RobMeades/spider_launcher/README.md

# Introduction
This repo contains the 3D printed parts and software for the spider launcher, a Halloween feature intended to scare \[playfully\].  For assembly instructions see here:

https://www.meades.org/misc/halloween_2026/halloween_2026.html#Something_Scary_In_The_South_West_Corner
