RobMeades/spider_launcher/sounds/README.md

These are the sounds played by the audio board in the spider launcher.

`00004.mp3` is the main sound, the one played while the spider is jumping, which also has an Audacity (v2) project file since it is a mixture of these two:

https://freesound.org/people/Mastersoundboy2005/sounds/737273/
https://sounds.sfxengine.com/big-spider-attack-jp5xxakt.wav

`00005.mp3` is mostly just this sound, amplified in two steps:

https://freesound.org/people/InsanityZeta/sounds/702986/
