RobMeades/spider_launcher/blender/spider_launcher_box.stl

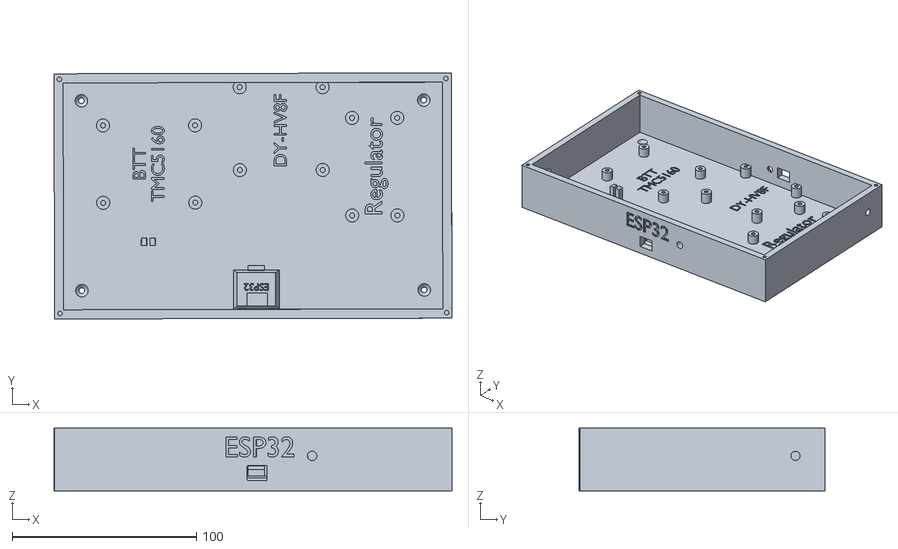
[picture p1: CAD file, 2026-10-25]
blender/spider_launcher_box.stl
216.2 x 133.6 x 34.0
