RobMeades/spider_launcher/blender/spider_launcher_winch_wheel.stl

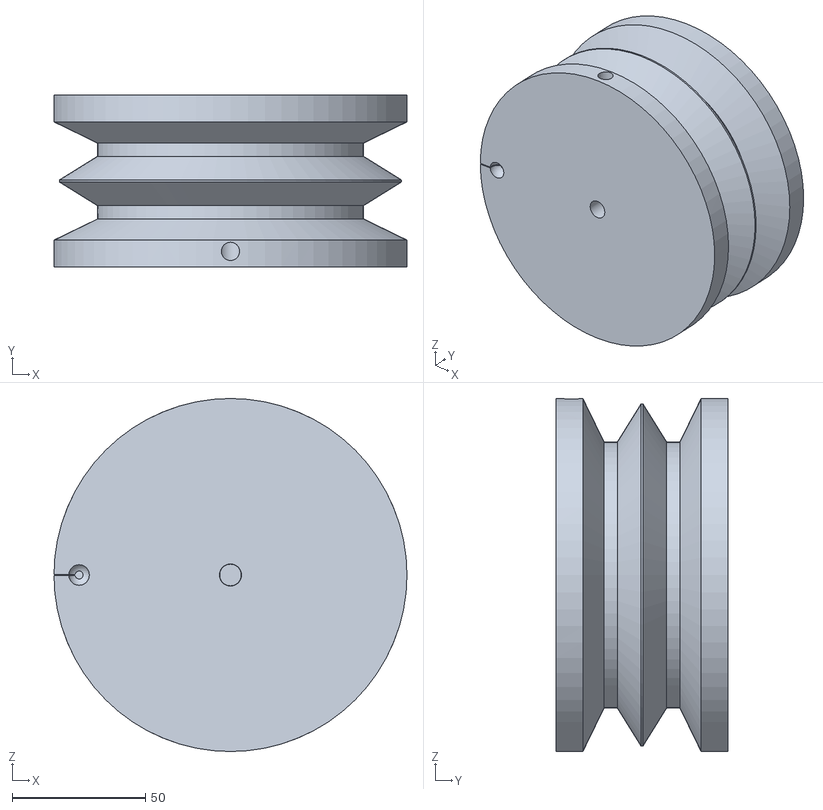
[picture p2: CAD file, 2026-10-25]
blender/spider_launcher_winch_wheel.stl
132.6 x 64.4 x 132.6
