RobMeades/spider_launcher/blender/spider_launcher_winch_mount_motor_side.stl

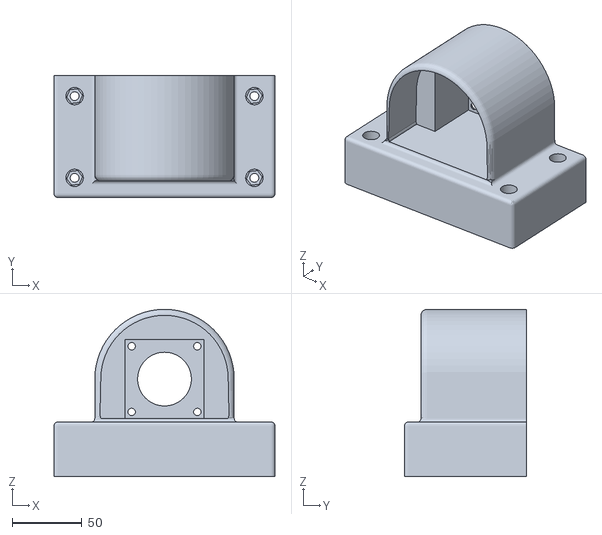
[picture p3: CAD file, 2026-10-23]
blender/spider_launcher_winch_mount_motor_side.stl
158.4 x 87.5 x 120.0
