RobMeades/spider_launcher/blender/spider_launcher_winch_mount_spacer_x2.stl

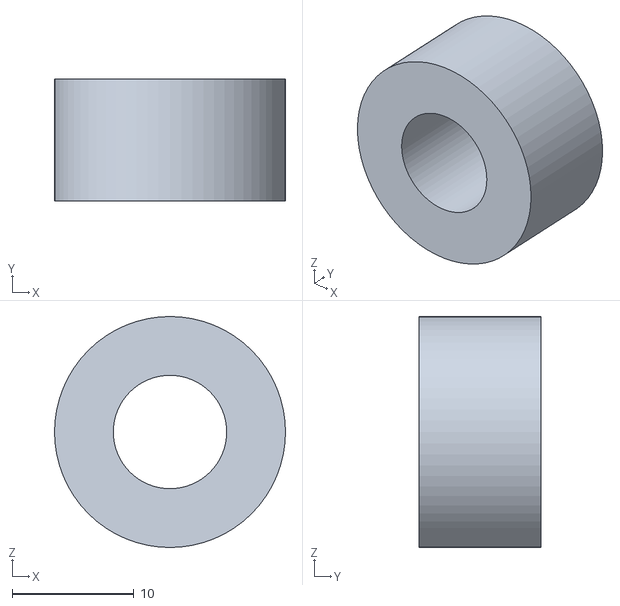
[picture p4: CAD file, 2026-10-23]
blender/spider_launcher_winch_mount_spacer_x2.stl
19.0 x 10.0 x 19.0
