RobMeades/spider_launcher/blender/spider_launcher_box_speaker_housing.stl

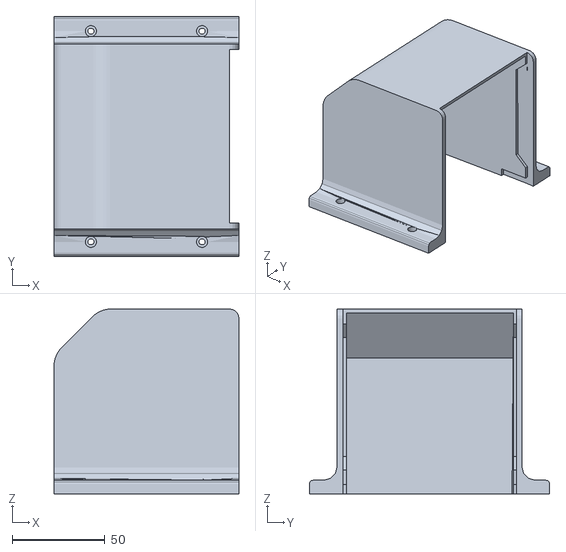
[picture p5: CAD file, 2026-10-16]
blender/spider_launcher_box_speaker_housing.stl
100.0 x 129.9 x 100.0
