RobMeades/spider_launcher/blender/spider_launcher_box_lid.stl

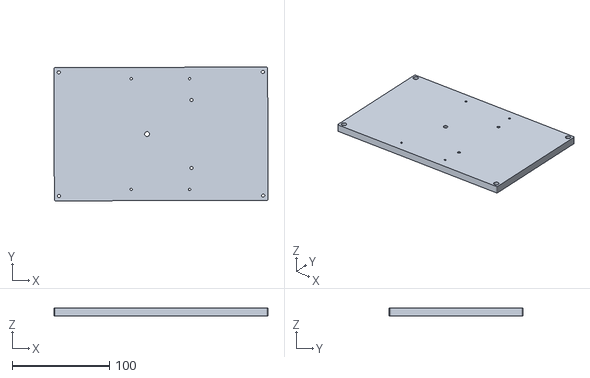
[picture p6: CAD file, 2026-10-16]
blender/spider_launcher_box_lid.stl
220.2 x 137.7 x 8.00
