RobMeades/spider_launcher/blender/spider_launcher_box_speaker_front.stl

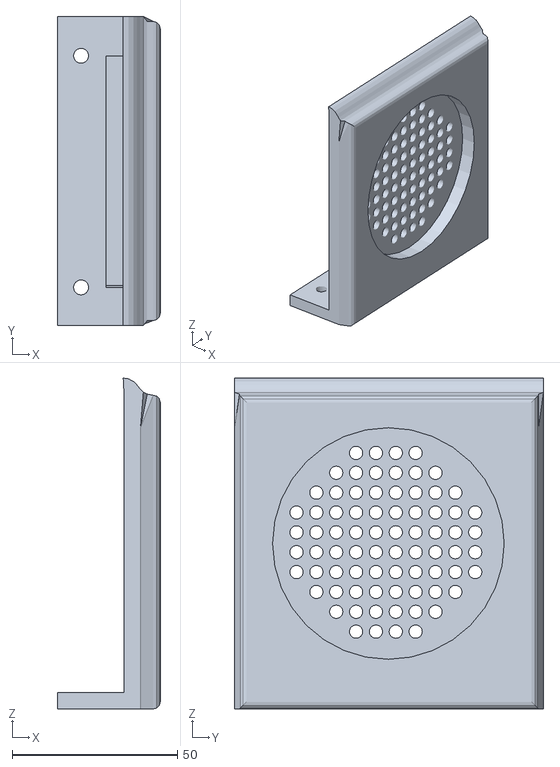
[picture p7: CAD file, 2026-10-16]
blender/spider_launcher_box_speaker_front.stl
31.0 x 93.4 x 100.0
