RobMeades/spider_launcher/blender/spider_launcher_spider_eye_big_lens_x2.stl

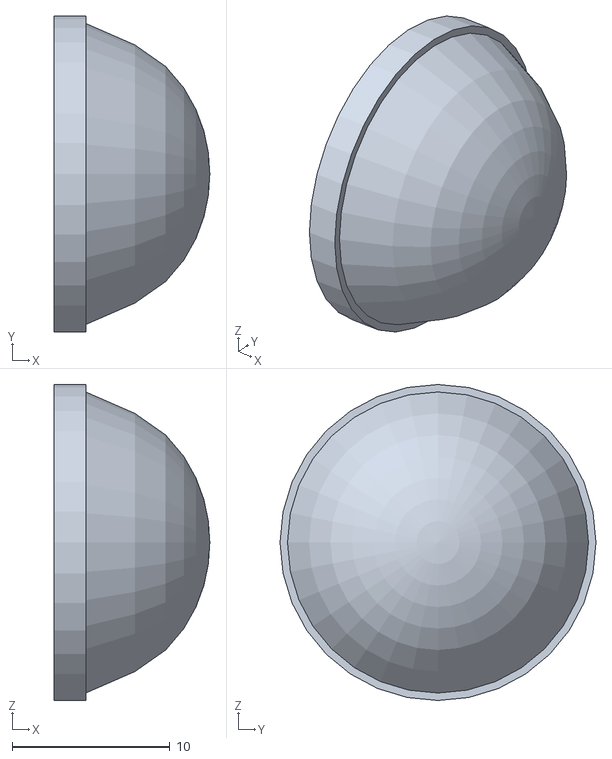
[picture p8: CAD file, 2026-10-11]
blender/spider_launcher_spider_eye_big_lens_x2.stl
9.85 x 20.0 x 20.0
