RobMeades/spider_launcher/blender/spider_launcher_spider_eye_mount.stl

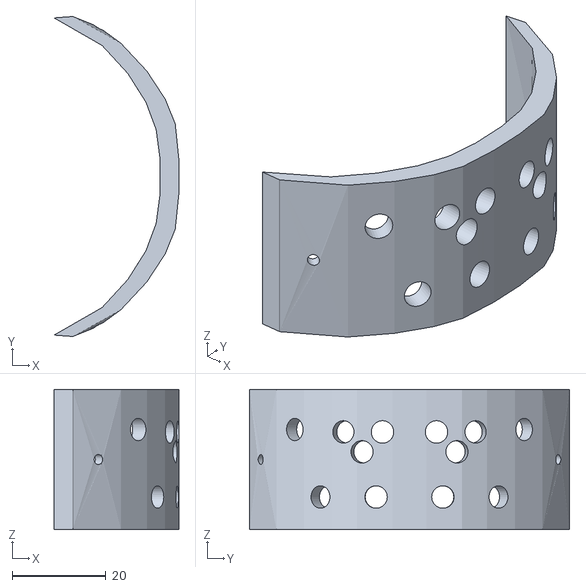
[picture p9: CAD file, 2026-10-09]
blender/spider_launcher_spider_eye_mount.stl
26.7 x 68.4 x 30.0
