RobMeades/spider_launcher/blender/spider_launcher_spider_box.stl

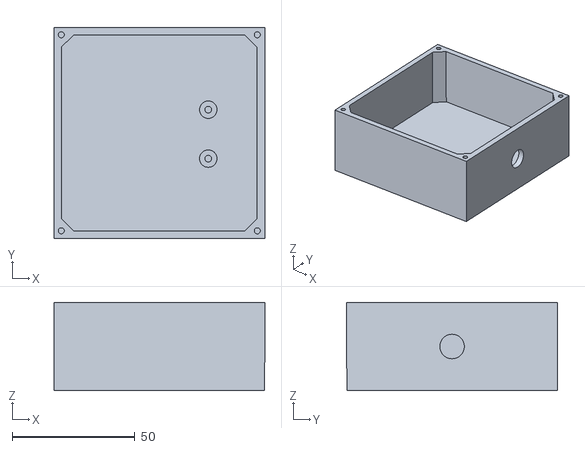
[picture p10: CAD file, 2026-10-09]
blender/spider_launcher_spider_box.stl
86.1 x 86.1 x 36.0
