RobMeades/spider_launcher/blender/spider_launcher_spider_box_lid.stl

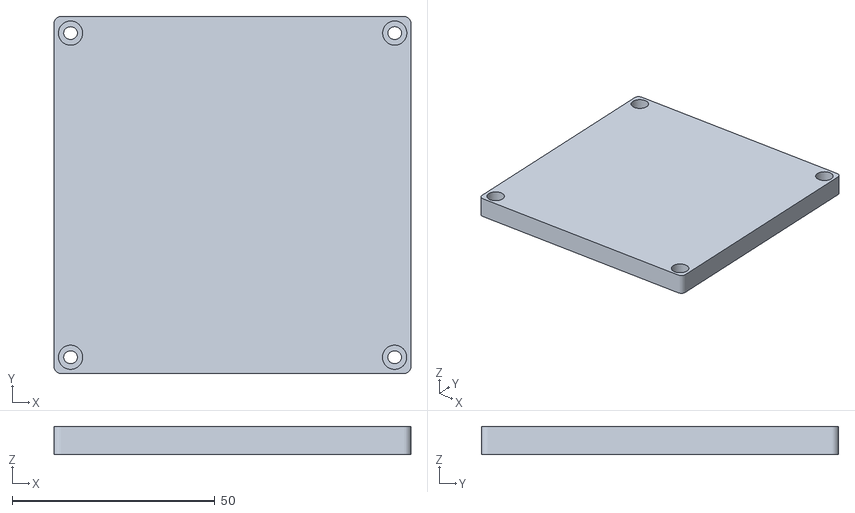
[picture p11: CAD file, 2026-10-09]
blender/spider_launcher_spider_box_lid.stl
88.1 x 88.1 x 7.00
