RobMeades/spider_launcher/blender/spider_launcher_platform_cable_joint_x2.stl

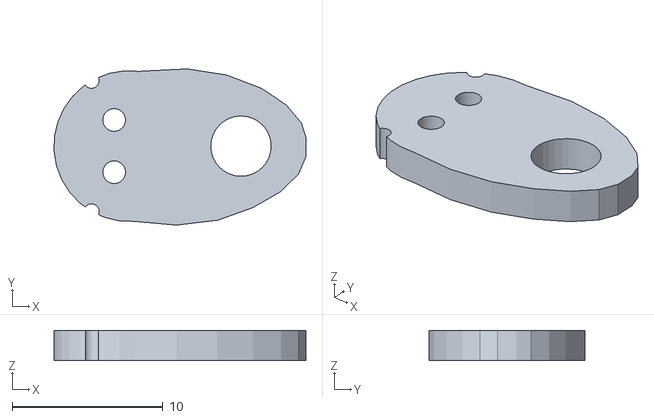
[picture p12: CAD file, 2026-10-05]
blender/spider_launcher_platform_cable_joint_x2.stl
16.7 x 10.4 x 2.00
