RobMeades/spider_launcher/blender/spider_launcher_winch_mount_non-motor_side_lower.stl

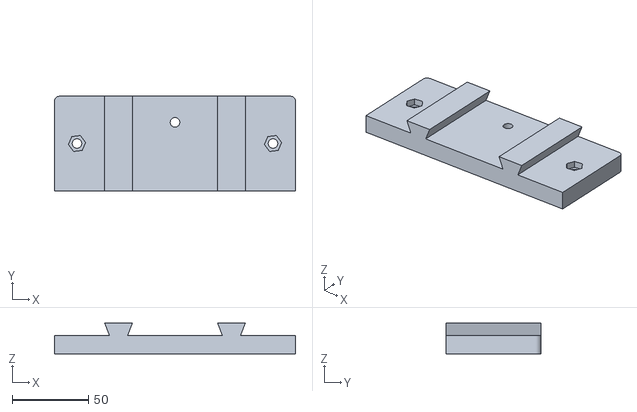
[picture p13: CAD file, 2026-10-02]
blender/spider_launcher_winch_mount_non-motor_side_lower.stl
158.4 x 62.2 x 20.1
