RobMeades/spider_launcher/blender/spider_launcher_box_lid_usb_c_hole_cap_x2.stl

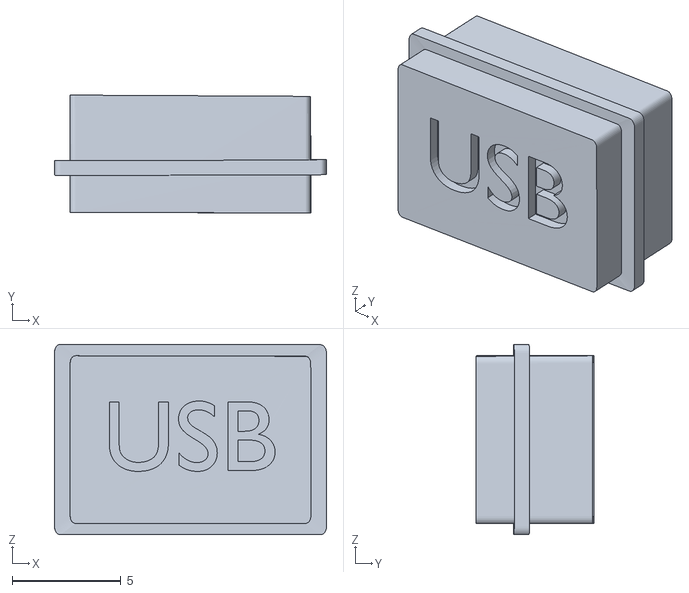
[picture p14: CAD file, 2026-10-02]
blender/spider_launcher_box_lid_usb_c_hole_cap_x2.stl
12.5 x 5.42 x 8.77
