RobMeades/spider_launcher/blender/spider_launcher_winch_motor_bracket.stl

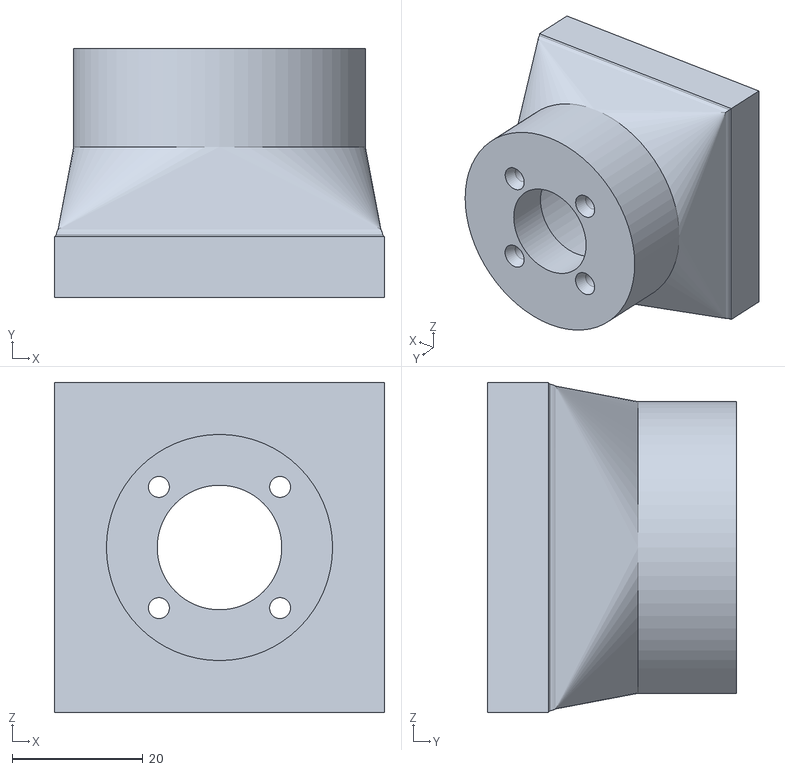
[picture p15: CAD file, 2026-10-02]
blender/spider_launcher_winch_motor_bracket.stl
50.4 x 38.0 x 50.4
