RobMeades/spider_launcher/blender/spider_launcher_pole_top_bracket.stl

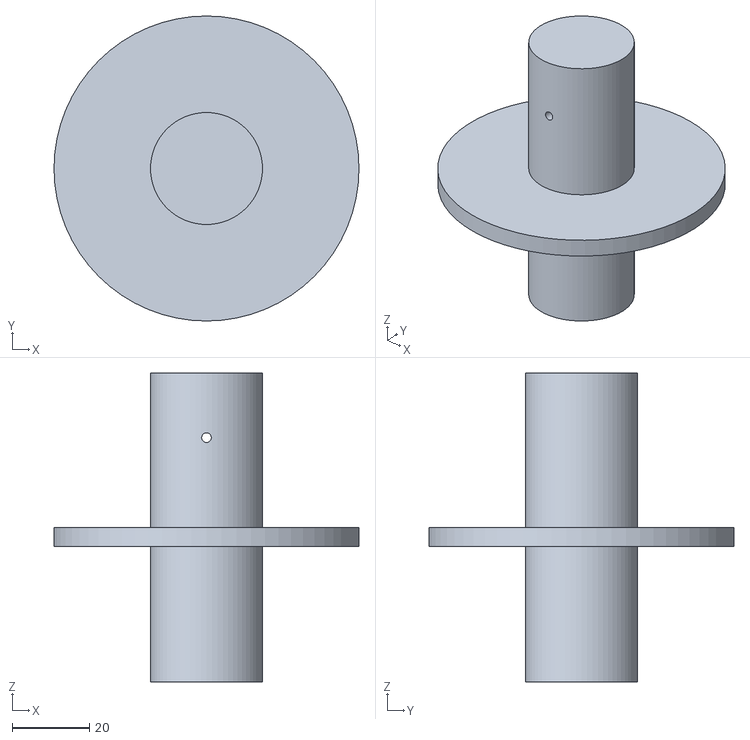
[picture p16: CAD file, 2026-10-01]
blender/spider_launcher_pole_top_bracket.stl
79.0 x 79.0 x 80.0
