RobMeades/spider_launcher/blender/spider_launcher_platform.stl

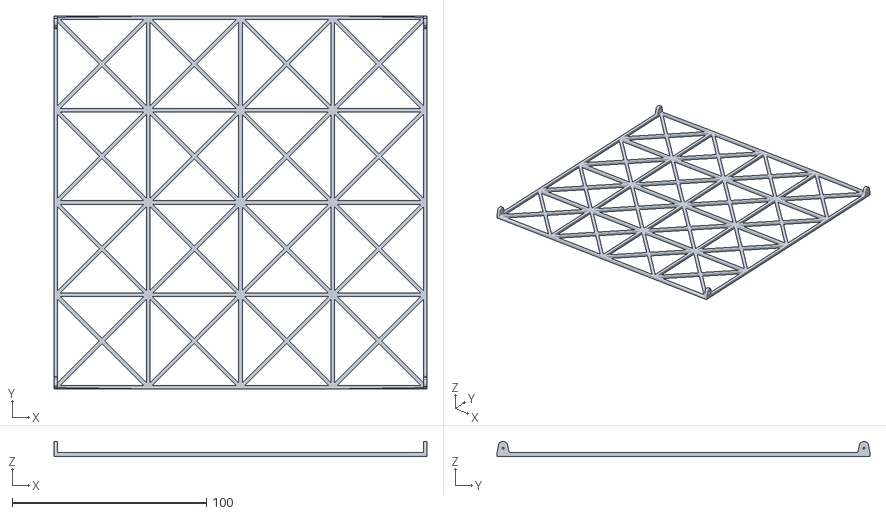
[picture p17: CAD file, 2026-10-01]
blender/spider_launcher_platform.stl
191.9 x 191.9 x 7.65
