RobMeades/spider_launcher/blender/spider_launcher_winch_wheel_nylon_line_bead_x2.stl

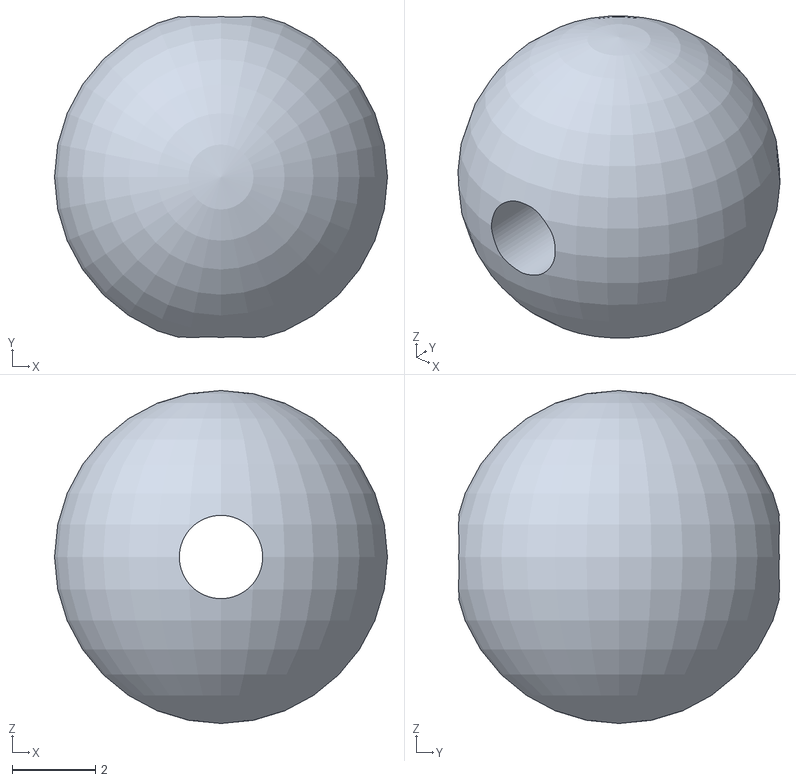
[picture p18: CAD file, 2026-10-01]
blender/spider_launcher_winch_wheel_nylon_line_bead_x2.stl
8.00 x 7.72 x 8.00
