RobMeades/spider_launcher/blender/spider_launcher_pole_cap_x2.stl

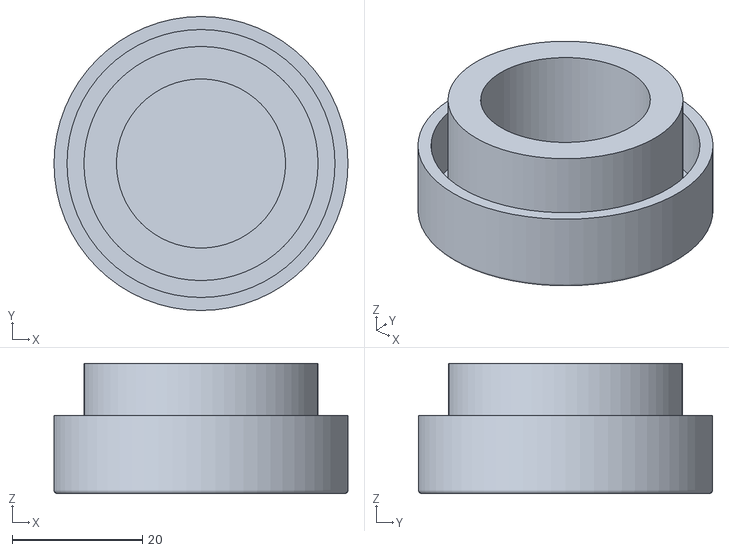
[picture p19: CAD file, 2026-10-01]
blender/spider_launcher_pole_cap_x2.stl
45.2 x 45.2 x 20.1
