RobMeades/spider_launcher/blender/spider_launcher_winch_mount_non-motor_side_upper.stl

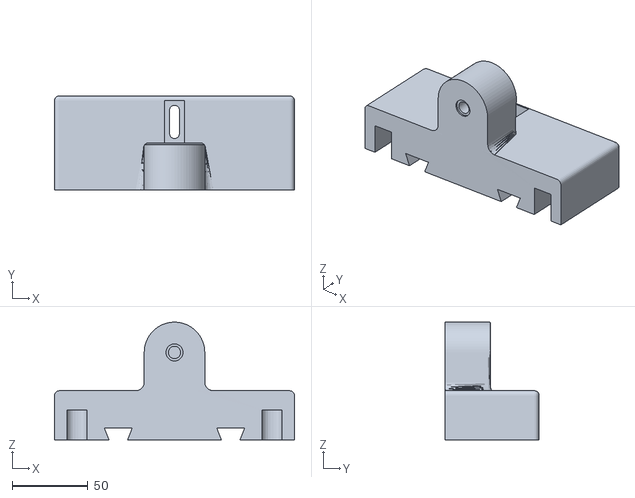
[picture p20: CAD file, 2026-10-01]
blender/spider_launcher_winch_mount_non-motor_side_upper.stl
158.4 x 62.2 x 77.7
