RobMeades/spider_launcher/blender/spider_launcher_nylon_line_guide_x2.stl

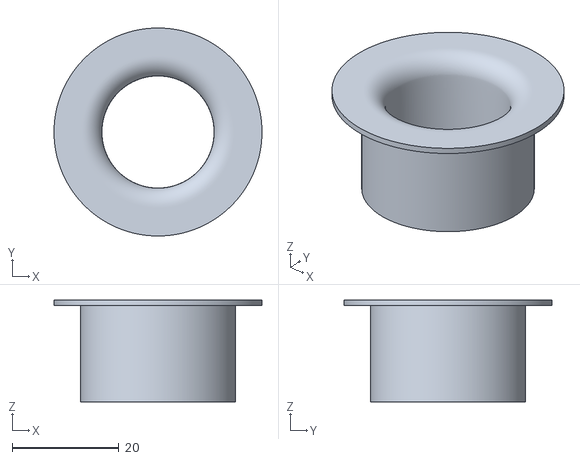
[picture p21: CAD file, 2026-10-01]
blender/spider_launcher_nylon_line_guide_x2.stl
38.9 x 38.9 x 19.0
