RobMeades/spider_launcher/blender/spider_launcher_winch_qrd1114_holder.stl

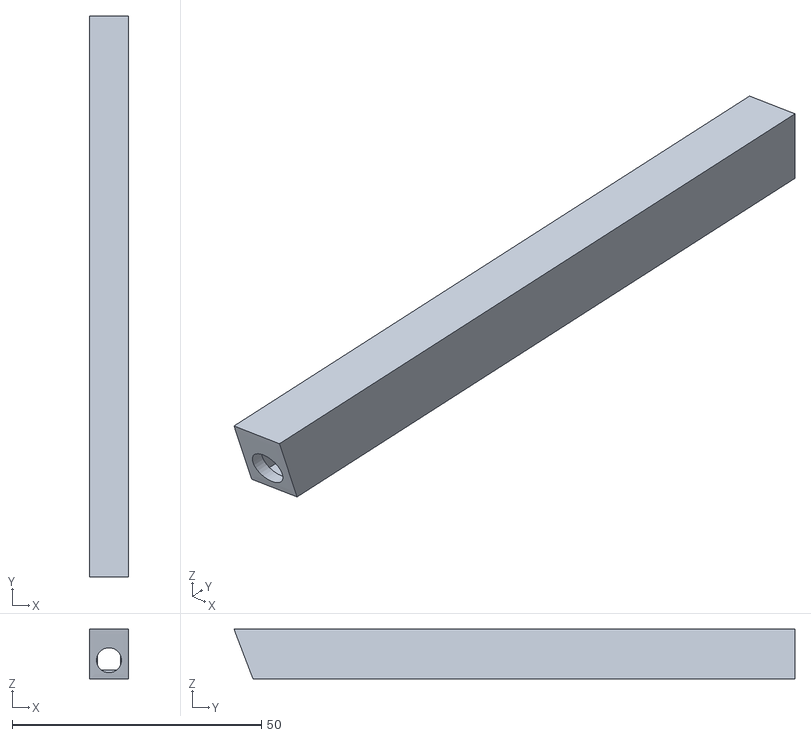
[picture p22: CAD file, 2026-10-01]
blender/spider_launcher_winch_qrd1114_holder.stl
7.75 x 112.5 x 10.0
