RobMeades/spider_launcher/blender/spider_launcher_pole_bug_eyes.stl

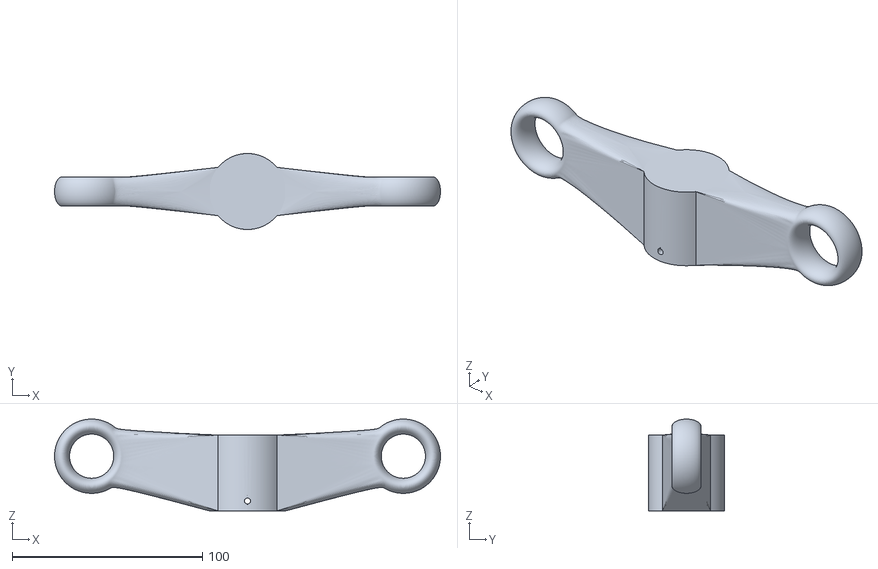
[picture p23: CAD file, 2026-10-01]
blender/spider_launcher_pole_bug_eyes.stl
203.0 x 40.0 x 48.3
