RobMeades/spider_launcher/blender/spider_launcher_pole_spacer_x2.stl

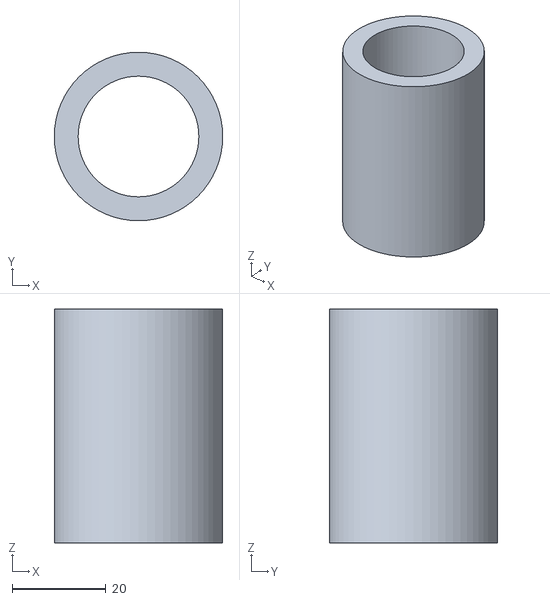
[picture p24: CAD file, 2026-10-01]
blender/spider_launcher_pole_spacer_x2.stl
36.0 x 36.0 x 50.0
