RobMeades/spider_launcher/blender/spider_launcher_winch_mount_non-motor_side_spacer.stl

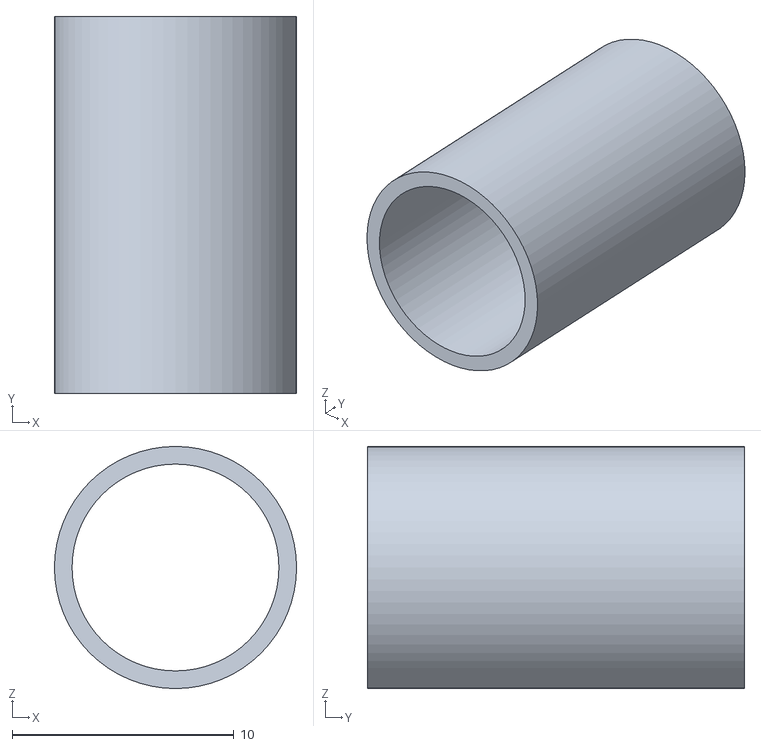
[picture p25: CAD file, 2026-10-01]
blender/spider_launcher_winch_mount_non-motor_side_spacer.stl
10.9 x 17.0 x 10.9
