RobMeades/spider_launcher/(list of files, cad)

Other CAD files:
blender/spider_launcher.blend
