RobMeades/spider_launcher/(commit log)

2026-10-01 WIP: checking in Blender stuff.
    [spider_launcher.blend, spider_launcher_nylon_line_guide_x2.stl, spider_launcher_platform.stl, spider_launcher_platform_cable_joint_x2.stl, spider_launcher_pole_bug_eyes.stl, spider_launcher_pole_cap_x2.stl, spider_launcher_pole_spacer_x2.stl, spider_launcher_pole_top_bracket.stl]
2026-10-02 More WIP: main bits mostly correct, early version of box added.
    [spider_launcher.blend, spider_launcher_box.stl, spider_launcher_box_lid.stl, spider_launcher_box_lid_usb_c_hole_cap.stl, spider_launcher_winch_motor_bracket.stl, spider_launcher_winch_mount_non-motor_side_lower.stl]
2026-10-05 Box is now correct, box lid should be also but needs testing.
    [spider_launcher.blend, spider_launcher_box.stl, spider_launcher_box_lid.stl, spider_launcher_box_lid_usb_c_hole_cap_x2.stl, spider_launcher_platform_cable_joint_x2.stl]
2026-10-05 Initial version of ESP32 code: just something that compiles, nothing more than that.
    [partitions.csv]
2026-10-06 Store current height in retained RAM so that we can survive a local reset, reorganise all internal data structures for simpler code.
    [spider_launcher.c]
2026-10-06 WIP check-in: the basics of a state machine in place. Time now to get the code reading a QRD1114 sensor and driving audio and the motor.
2026-10-07 First version of brushless motor driver: compiles, not tested.
2026-10-09 Add box and eye-mount for the spider itself, plus make a little more room under the lid of the main electronics box.
    [spider_launcher.blend, spider_launcher_box_lid.stl, spider_launcher_spider_box.stl, spider_launcher_spider_box_lid.stl, spider_launcher_spider_eye_mount.stl]
2026-10-09 Slight reduction in LED hole size in the spider eye mount for a closer fit.
    [spider_launcher.blend, spider_launcher_spider_eye_mount.stl]
2026-10-11 Add lens to cover the two groups of three LEDs, making them look more like the two larger eyes.
    [spider_launcher.blend, spider_launcher_spider_eye_big_lens_x2.stl]
2026-10-12 Make debug LED breathe to indicate state, update duration of the jumping tune since I've modified it on the spider launcher.
2026-10-13 Add comment that this Android application matches BLE_INTERFACE_VERSION 0 on the ESP32 side.
2026-10-13 Add the sounds played by the audio board.
2026-10-15 INTERFACE CHANGE: the emergency stop command, which was previously stateless, now becomes an enable/disable which is kept in retained RAM (NOT non-voltatile RAM) so that it will persist across a rese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
2026-10-15 Update the Android application to match the changes on the ESP32 side (emergency stop is now an enable/disable), BLE_INTERFACE_VERSION 1.
2026-10-16 Add speaker housing.
2026-10-19 motor_brushless -> motor ('cos brushelss is irrelevant), the motor handle is now typed properly and modify the BLE API so that the STEP UP and STEP DOWN commands become MOVE_UP and MOVE_DOWN commands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
2026-10-19 WIP [last tested] commit before switching to stepper motor.
2026-10-23 ESP32 code version with stepper about to enter testing. Note that the diag pin is now set to -1 until we find a need for it (was on pin 2).
2026-10-23 Motor side of the winch mount, winch wheel and spacers redesigned for stepper motor, QRD1114 holder dropped as a stepper motor shouldn't need it.
2026-10-24 Remove StallGuard from the implementation: spent a few hours experimenting with it, assisted by ChatGPT, and determined that (a) it would never be able to detect a loss of steps (that would require s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
2026-10-25 Correct jiggle height for real winch wheel and move IO2 of the audio board to GPIO 2 from GPIO 43 in order to avoid the boot ROM TXD (which made the spider shout "TWO" quite loudly sometimes during b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
2026-10-25 Box tweaked for stepper-motor driver and bi-directional level shifter to the audio controls.
